nemanja-krsman/interactive-game-control-system/README.md

# Interactive Game Control System

Super Wario is a timed, interactive physical game. Players progress through
sensor-triggered stages while custom electronics control motors and pneumatic
mechanisms and track the elapsed time.

I designed and built the electronics and software for this project myself,
including the control boards, PCB designs, firmware, and system integration.

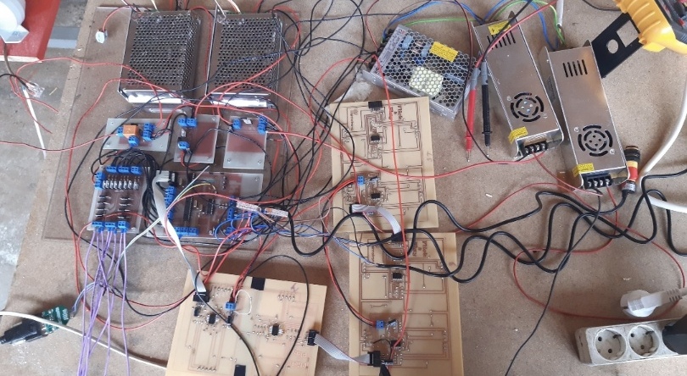
[picture p1: doc/Full ECUs + Displays.jpg]
Control electronics and display modules assembled for testing


*Control electronics and displays during system integration.*

## System Overview

The project combines a physical game structure and mechanisms with a
microcontroller-based control system:

1. Buttons and sensors detect game events.
2. The input firmware sends numbered event messages over a serial connection.
3. The main firmware manages the elapsed-time display, while the output
   firmware advances the game sequence.
4. The output firmware switches the motor and pneumatic control outputs.
5. Separate driver boards interface the low-voltage control signals to the
   motors, pneumatic equipment, and switched loads.

The output-controller firmware describes this game sequence:

| Event ID | Game event | Controller action |
|---|---|---|
| `1` | Start button | Start a new round and reset the stage timer |
| `2` | Sensor 1 | Activate Motor 1 |
| `6` | Sensor 2 | Stop Motor 1 and begin the randomized pneumatic-output stage |
| `4` | Sensor 3 | Stop the pneumatic stage and activate Motor 2 |
| `5` | End button | End the round |

The output firmware also includes a timed stage/pass limit. The event IDs and
actions above describe the current firmware.

## Hardware Overview

The hardware is modular, with separate control and driver boards for different
parts of the game:

| Hardware | Role |
|---|---|
| Main/control board | Reads low-voltage input signals, provides logic-level outputs, and connects to the timer display |
| Input controller | Scans buttons and sensors and reports input events to the other controllers |
| Pneumatic board | Provides eight input and eight output channels for controlling pneumatic equipment |
| Motor board | Uses a MOSFET to switch the motor speed-controller input; it does not directly drive the DC motor |
| Power board | Uses a relay to switch a load |
| Display modules | Serial-connected two-digit modules used to show elapsed game time |
| Power supplies | Two power supplies: 12 V / 30 A and 5 V / 30 A; the main board accepts 12–24 V input |
| Sensors and buttons | Active-low inputs |

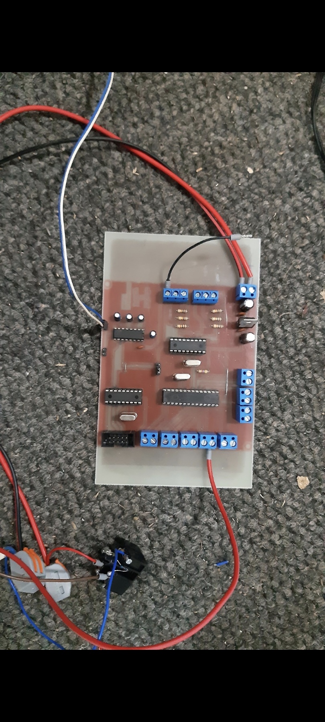
[picture p2: doc/ECU_1 - Main Board.jpg]
Main control board assembly


*Assembled main control board.*

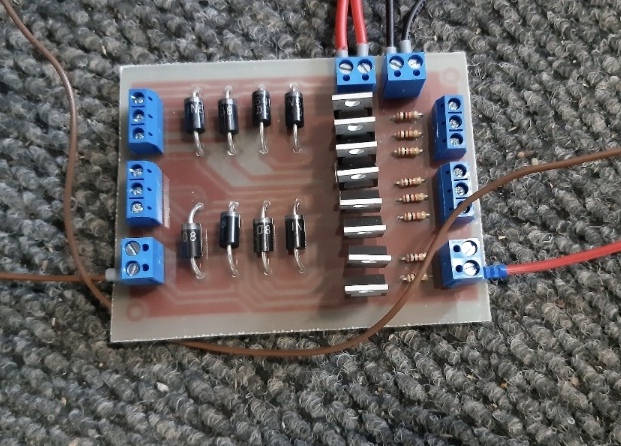
[picture p3: doc/ECU_2 - Pneu Board.jpg]
Pneumatic control board


*Pneumatic board with its input and output connections.*

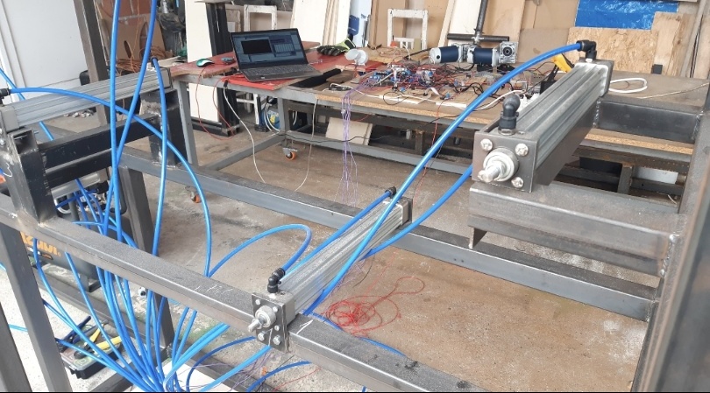
[picture p4: doc/Pneumatics.jpg]
Pneumatic mechanism installed on the game structure


*Pneumatic mechanism and game structure.*

The repository also contains PCB and schematic project files for the main,
motor, pneumatic, and power boards. For full connector descriptions and wiring
guidance, see the [PDF hardware manual](<Manual/Manual.pdf>) or the
[editable Word manual](<Manual/Manual.docx>).

## Firmware Overview

Firmware is written in C for Microchip PIC microcontrollers and is organized
into three MPLAB X projects:

| Firmware project | Microcontroller in source | Responsibility |
|---|---|---|
| `SuperWarioINPUTS.X` | PIC16F628A | Scans active-low inputs and transmits input numbers |
| `SuperWarioMAIN/SuperMarioMAIN.X` | PIC16F628A | Receives start/stop events and updates the elapsed-time display |
| `SuperWarioOUTPUTS.X` | PIC16F876 | Runs the game sequence and controls motor, pneumatic, and status outputs |

The firmware uses asynchronous UART serial communication configured for
9600 baud. Input messages are sent as ASCII event numbers followed by CR/LF.
The output controller uses the received events to step through the game and
generate timed, randomized activations on pneumatic output channels 1–8.
Motor-control signals are assigned to outputs 9 and 10; output 16 is also used
as a status/indicator signal in the output firmware.

The display code shifts digit data serially to the display hardware. Timing is
maintained by the microcontroller timers, while the output firmware also
enforces a time limit during a game stage.

### System algorithm

```mermaid
flowchart TD
    A([Power on]) --> B[Initialize input, timer/display, and output controllers]
    B --> C{Start button event 1?}
    C -- No --> C
    C -- Yes --> D[Reset and start elapsed-time display]
    D --> E{Sensor 1 event 2?}
    E -- No --> E
    E -- Yes --> F[Activate Motor 1]
    F --> G{Sensor 2 event 6?}
    G -- No --> G
    G -- Yes --> H[Stop Motor 1]
    H --> I[Pulse randomized pneumatic outputs]
    I --> J{Sensor 3 event 4<br/>or stage time limit?}
    J -- No --> I
    J -- Yes --> K[Switch pneumatic outputs off]
    K --> L{Sensor 3 event 4?}
    L -- No --> L
    L -- Yes --> M[Activate Motor 2]
    M --> N{End button event 5?}
    N -- No --> N
    N -- Yes --> O[Stop timer and controlled outputs]
    O --> C
```

This is the high-level game flow represented by the firmware. Individual
controllers handle their own part of the sequence; see their guides for
implementation details.

For details about each firmware unit, see the dedicated guides:

- [Inputs firmware](SuperWarioINPUTS.X/README.md)
- [Main/timer-display firmware](SuperWarioMAIN/SuperMarioMAIN.X/README.md)
- [Outputs/game-sequence firmware](SuperWarioOUTPUTS.X/README.md)

## Repository Contents

- `doc/` — project and electronics photos used in this README.
- `Manual/` — PDF and editable Word hardware manuals.
- `SuperWarioINPUTS.X/` — input-controller firmware.
- `SuperWarioMAIN/SuperMarioMAIN.X/` — timer/display-controller firmware.
- `SuperWarioOUTPUTS.X/` — output and game-sequence firmware.
- `SuperWarioPCB/` — main-board PCB and schematic projects.
- `SuperWarioPCB - MotorBoard/` — motor-driver PCB and schematic.
- `SuperWarioPCB - PneuBoard/` — pneumatic-board PCB and schematic.
- `SuperWario - PowerBoard/` — power-board PCB and schematic.
- `SuperWarioINPUTS_Proteus/`, `SuperWarioOUTPUTS_Proteus/`, and
  `SuperWarioMAIN/SuperMarioMAIN - Proteus/` — Proteus simulation projects.

Compiler used for the firmware is XC8 V1.38. The checked-in projects are legacy
embedded projects and may require a compatible MPLAB X setup to rebuild.

## Electronic Control Units

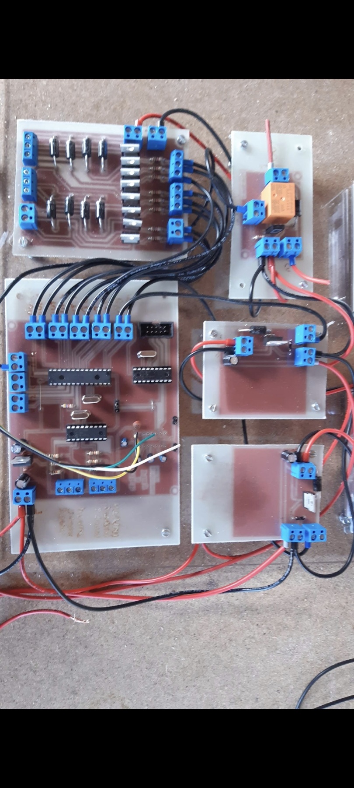
[picture p5: doc/Full Electronic ECUs.jpg]
Full electronic control units


*The electronic control units assembled for the Super Wario game.*

Images of the fully assembled game are not included due to intellectual
property restrictions. Please contact me if you would like more information
about the project.
