nemanja-krsman/interactive-game-control-system/doc/Addon Board - Power Board.jpg

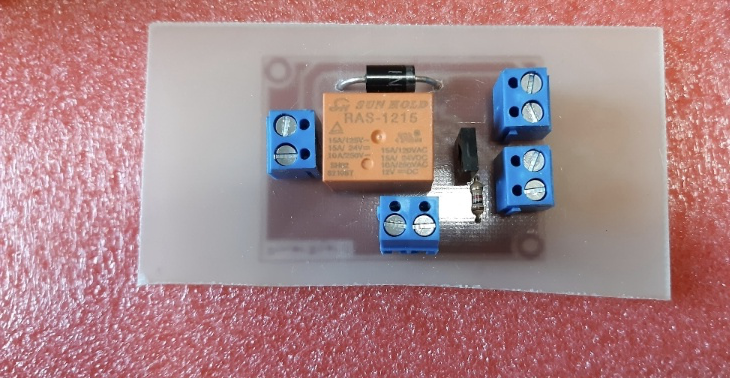
doc/Addon Board - Power Board.jpg
