nemanja-krsman/interactive-game-control-system/doc/Connections 7.jpg

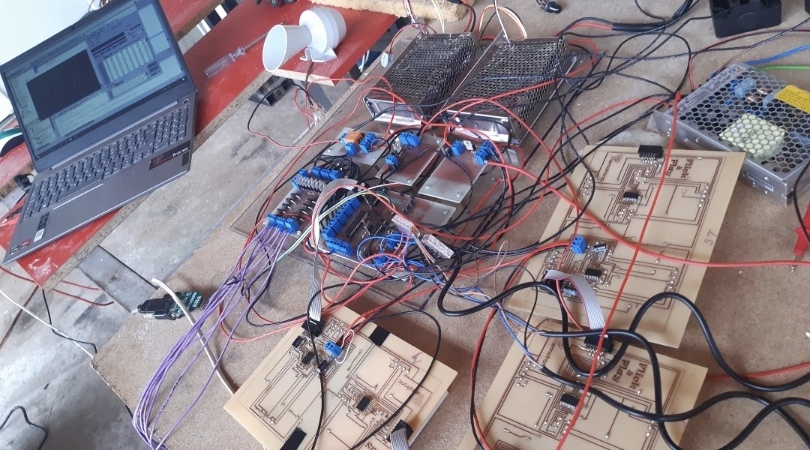
doc/Connections 7.jpg
