nemanja-krsman/interactive-game-control-system/doc/Connections_1.jpg

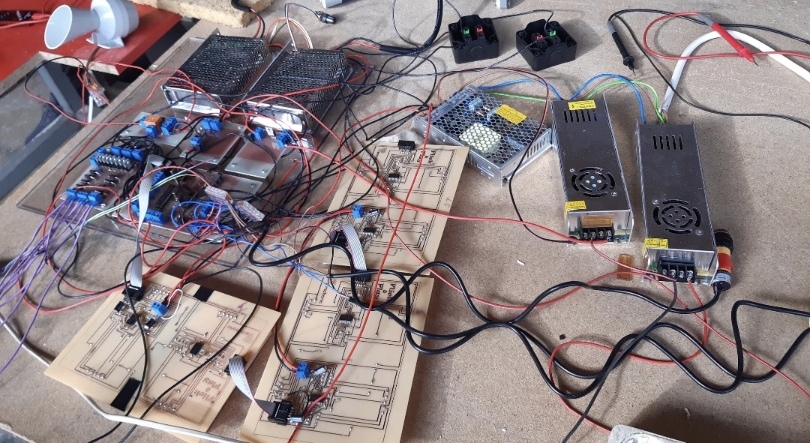
doc/Connections_1.jpg
