nemanja-krsman/interactive-game-control-system/doc/Connections_2.jpg

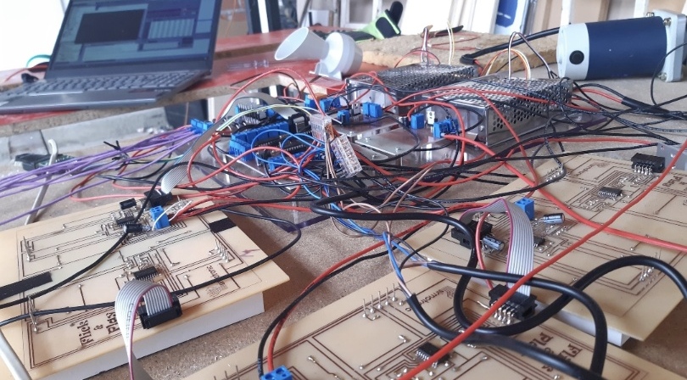
doc/Connections_2.jpg
