nemanja-krsman/interactive-game-control-system/doc/Connections_3.jpg

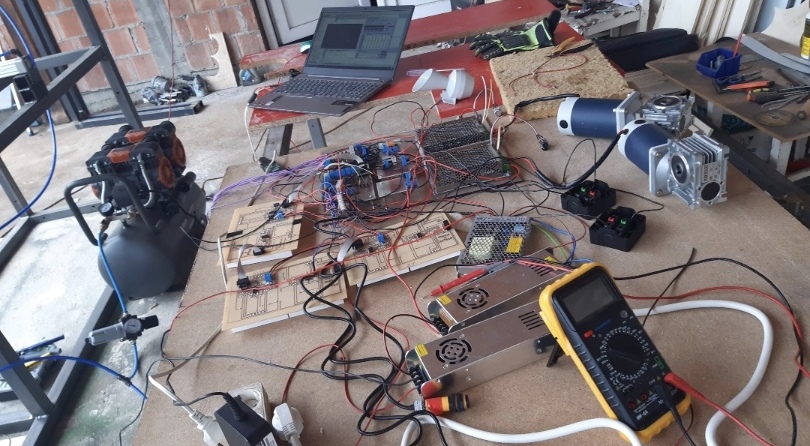
doc/Connections_3.jpg
