nemanja-krsman/interactive-game-control-system/doc/Connections_4.jpg

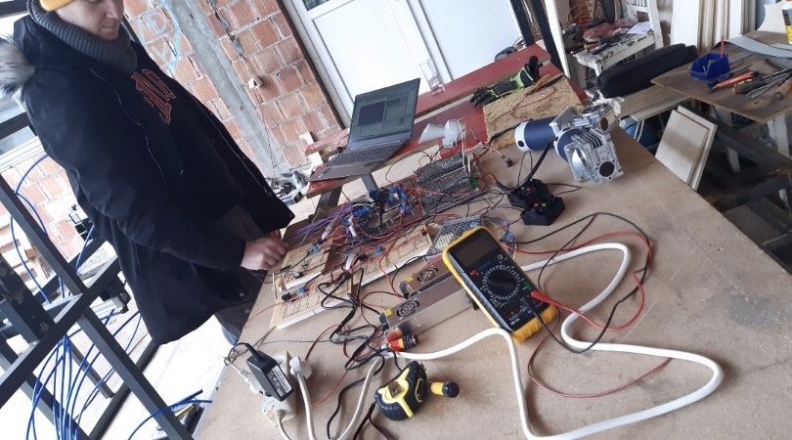
doc/Connections_4.jpg
