nemanja-krsman/interactive-game-control-system/doc/Connections_5.jpg

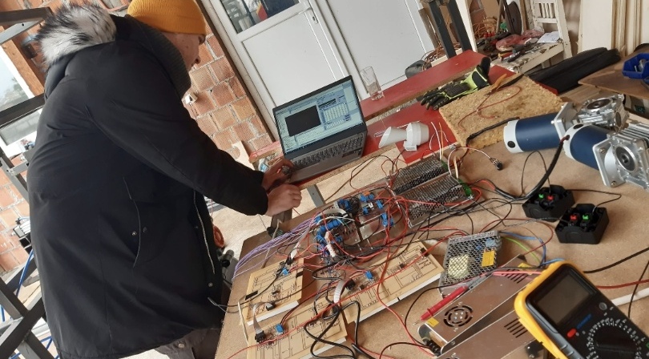
doc/Connections_5.jpg
