nemanja-krsman/interactive-game-control-system/doc/Connections_6.jpg

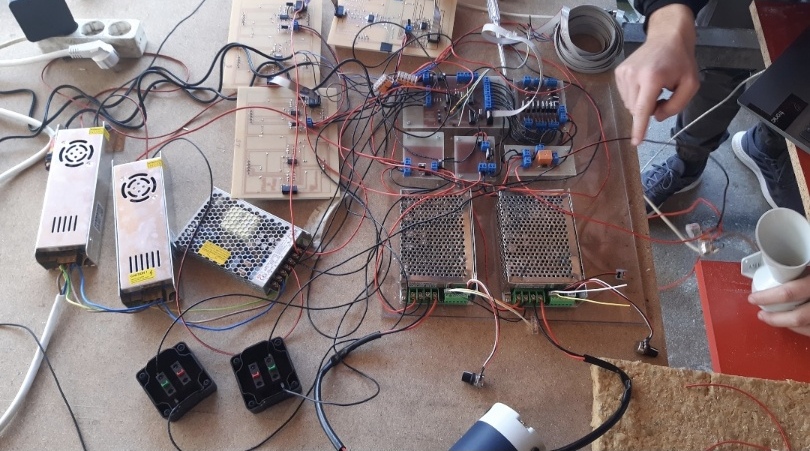
doc/Connections_6.jpg
