nemanja-krsman/interactive-game-control-system/doc/Display Backround 2.jpg

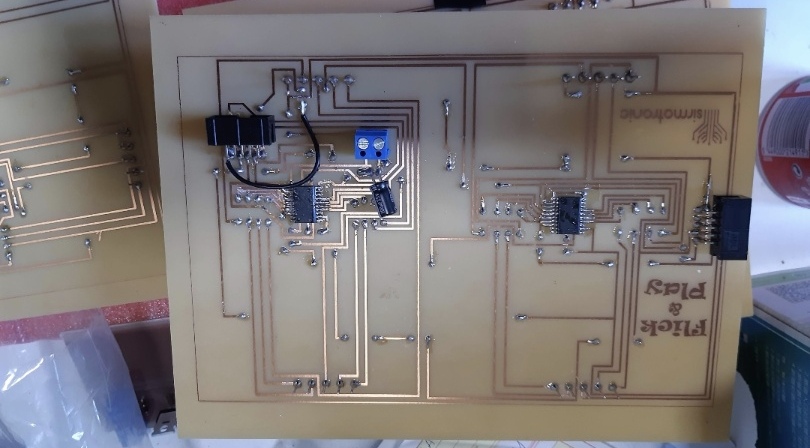
doc/Display Backround 2.jpg
