nemanja-krsman/interactive-game-control-system/doc/Display Backround.jpg

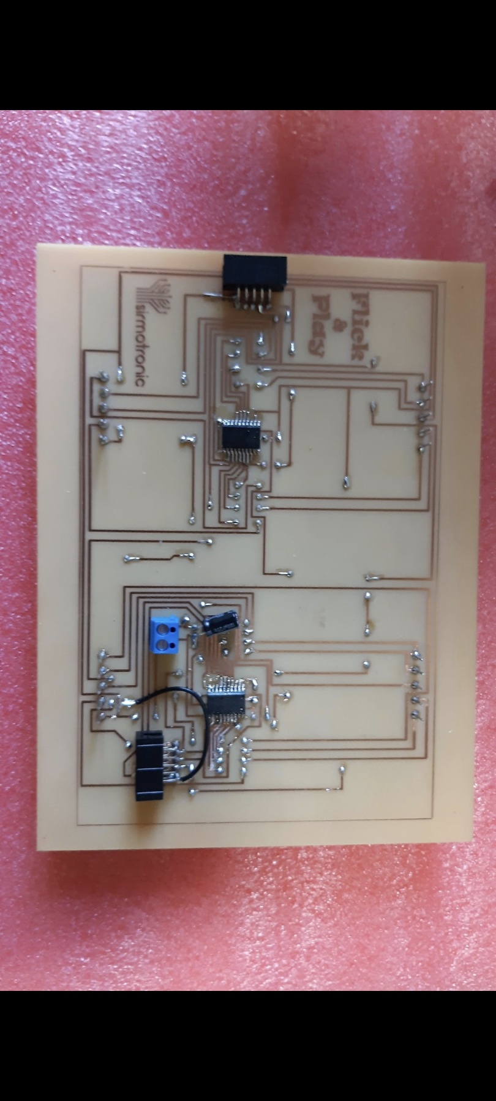
doc/Display Backround.jpg
