nemanja-krsman/interactive-game-control-system/doc/Pneumatic mechanism.jpg

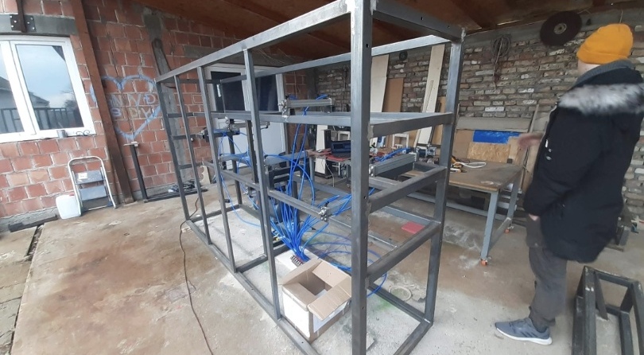
doc/Pneumatic mechanism.jpg
