nemanja-krsman/interactive-game-control-system/(list of files, cad)

Other CAD files:
SuperWarioMAIN/SuperMarioMAIN.X/dist/default/production/SuperMarioMAIN.X.production.obj
SuperWarioINPUTS.X/dist/default/production/SuperMarioINPUTS.X.production.obj
SuperWarioOUTPUTS.X/dist/default/production/SuperMarioOUTPUTS.X.production.obj
