nemanja-krsman/interactive-game-control-system/(list of files, drawings)

Other design files:
SuperWario - PowerBoard/PowerBoardPCB.PcbDoc
SuperWario - PowerBoard/PowerBoardScheme.SchDoc
SuperWarioINPUTS_Proteus/SuperMarioINPUTS.pdsprj
SuperWarioMAIN/SuperMarioMAIN - Proteus/SuperMarioMAIN.pdsprj
SuperWarioOUTPUTS_Proteus/SuperMarioOUTPUTS.pdsprj
SuperWarioPCB - MotorBoard/MotorBoardPCB.PcbDoc
SuperWarioPCB - MotorBoard/MotorBoardSchematic.SchDoc
SuperWarioPCB - PneuBoard/PneuBoardSchematic.SchDoc
SuperWarioPCB - PneuBoard/PneuBoardV2.PcbDoc
SuperWarioPCB/DebugPart.SchDoc
SuperWarioPCB/Inputs.SchDoc
SuperWarioPCB/MainGame.SchDoc
SuperWarioPCB/Outputs.SchDoc
SuperWarioPCB/PCB_V1.0.PcbDoc
SuperWarioPCB/PowerSupply.SchDoc
