nemanja-krsman/interactive-game-control-system/SuperWarioOUTPUTS.X/UART.h

#define SBIT_TXEN     5
#define SBIT_SPEN     7
#define SBIT_CREN     4


void UART_Init(int baudRate);
void UART_TxChar(char ch);
unsigned char UART_RxChar();
void UART_putst(register const char *str);
