nemanja-krsman/interactive-game-control-system/(commit log)

2026-10-30 All initial files added
    [DebugPart.SchDoc, Inputs.SchDoc, MainGame.SchDoc, MotorBoardPCB.PcbDoc, MotorBoardSchematic.SchDoc, Outputs.SchDoc, PCB_V1.0.PcbDoc, PneuBoardSchematic.SchDoc]
2026-11-02 Clarify power board and power supplies in README
    Updated the README to clarify the power board and power supplies sections, and removed redundant information about input channels.
2026-11-02 Simplify README.md by removing unnecessary details
    Removed redundant wording about wiring confirmation and build outputs.
